RobertBaruch/OurGrammer/pin_driver/pin_driver_pots.jpg

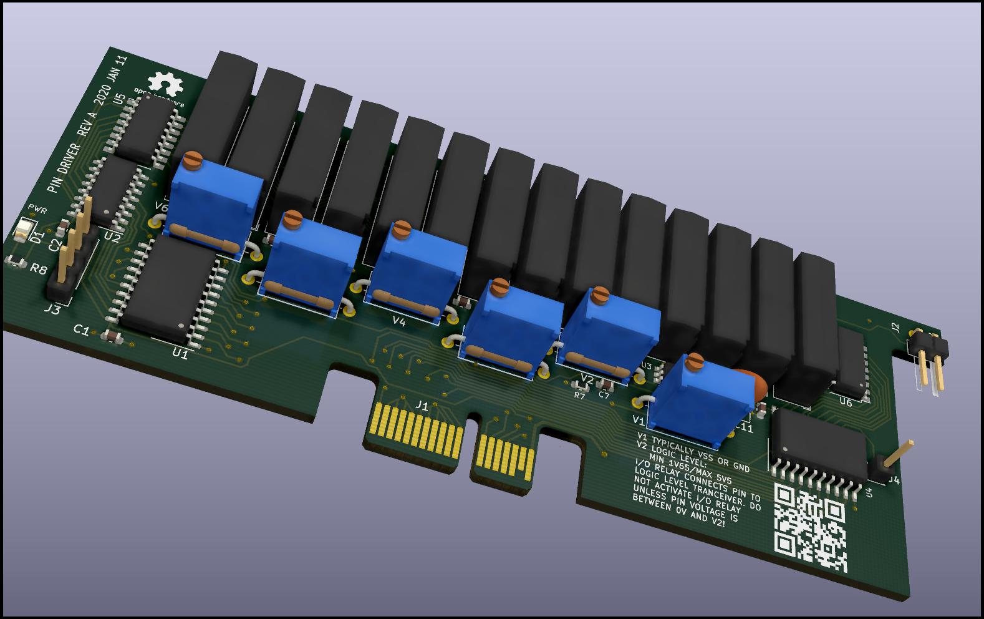
pin_driver/pin_driver_pots.jpg
