RobertBaruch/OurGrammer/pin_driver/pin_driver_qr.jpg

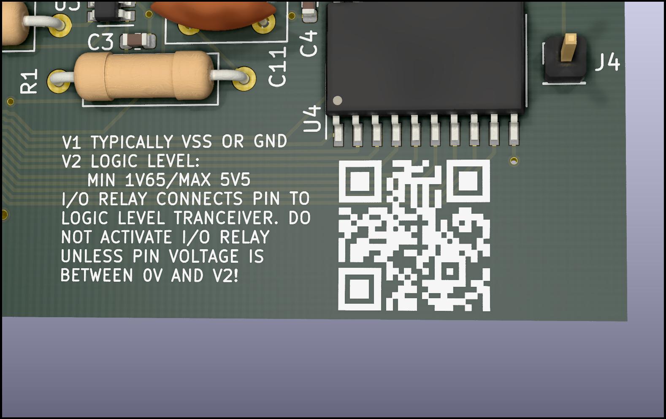
pin_driver/pin_driver_qr.jpg
