RobertBaruch/OurGrammer/pin_driver/pin_driver.jpg

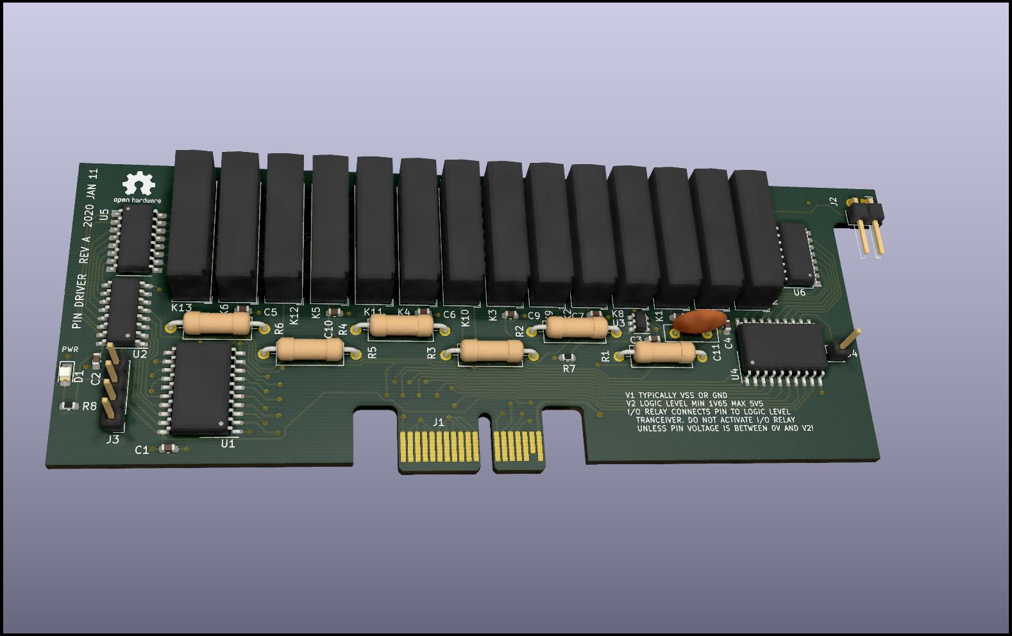
pin_driver/pin_driver.jpg
