RobertBaruch/OurGrammer/neg_voltages/voltages.kicad_pcb

## KiCad design neg_voltages/voltages.kicad_pcb (2020-05-23)

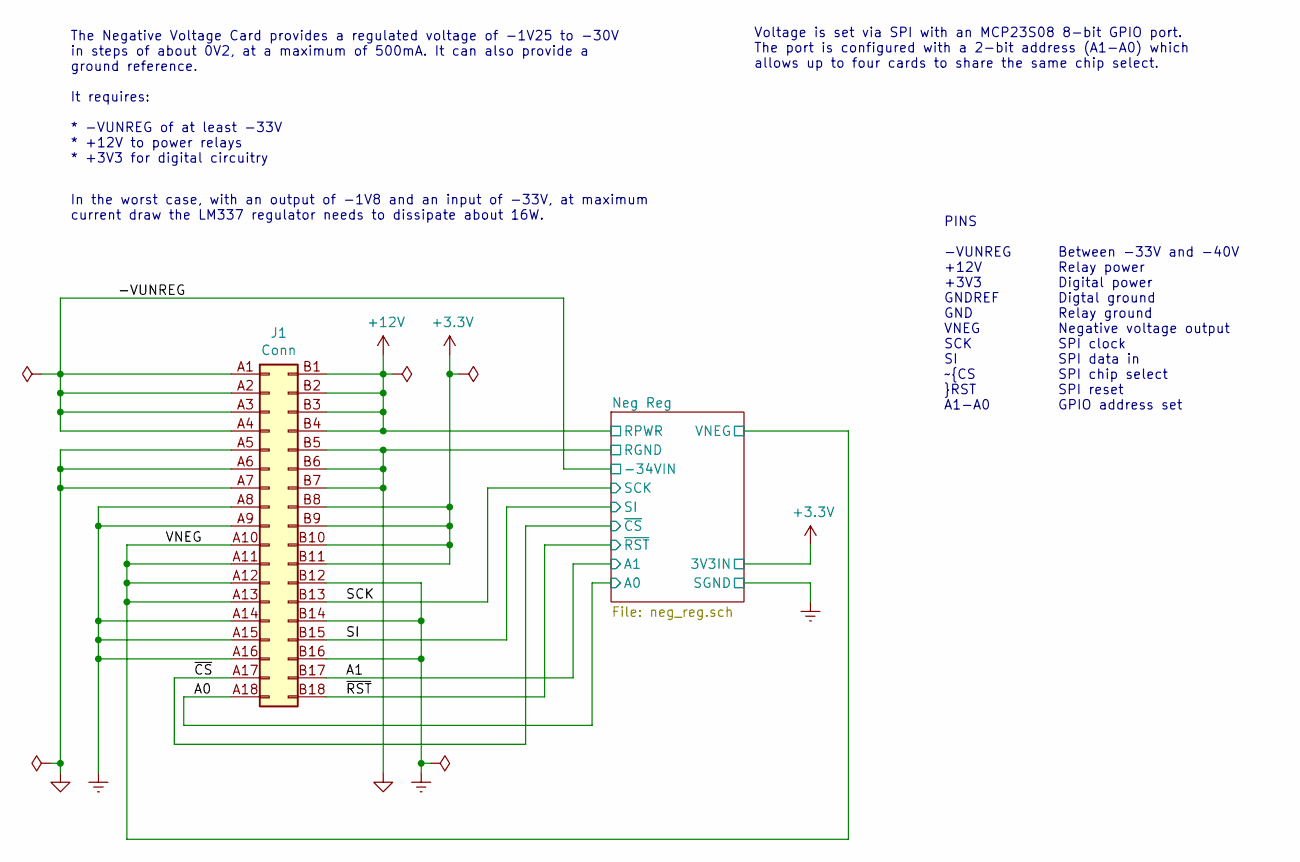
[picture p4: schematic voltages.sch]

Parts:
J1: Conn; BUS_PCIexpress_x1

Connections:
+3V3: J1.B8 (Pin_b8), J1.B9 (Pin_b9), J1.B10 (Pin_b10), J1.B11 (Pin_b11); also elsewhere on the board
+12V: J1.B1 (Pin_b1), J1.B2 (Pin_b2), J1.B3 (Pin_b3), J1.B4 (Pin_b4); also elsewhere on the board
/-VUNREG: J1.A1 (Pin_a1), J1.A2 (Pin_a2), J1.A3 (Pin_a3), J1.A4 (Pin_a4); also elsewhere on the board
/A0: J1.A18 (Pin_a18); also elsewhere on the board
/A1: J1.B17 (Pin_b17); also elsewhere on the board
/SCK: J1.B13 (Pin_b13); also elsewhere on the board
/SI: J1.B15 (Pin_b15); also elsewhere on the board
/VNEG: J1.A10 (Pin_a10), J1.A11 (Pin_a11), J1.A12 (Pin_a12), J1.A13 (Pin_a13); also elsewhere on the board
/~CS: J1.A17 (Pin_a17); also elsewhere on the board
/~RST: J1.B18 (Pin_b18); also elsewhere on the board
GND: J1.A5 (Pin_a5), J1.A6 (Pin_a6), J1.A7 (Pin_a7), J1.B5 (Pin_b5), J1.B6 (Pin_b6), J1.B7 (Pin_b7); also elsewhere on the board
GNDREF: J1.A8 (Pin_a8), J1.A9 (Pin_a9), J1.A14 (Pin_a14), J1.A15 (Pin_a15), J1.A16 (Pin_a16), J1.B12 (Pin_b12), J1.B14 (Pin_b14), J1.B16 (Pin_b16); also elsewhere on the board

Notes on the sheet:
The Negative Voltage Card provides a regulated voltage of -1V25 to -30V in steps of about 0V2, at a maximum of 500mA. It can also provide a ground reference. It requires: * -VUNREG of at least -33V * +12V to power relays * +3V3 for digital circuitry
In the worst case, with an output of -1V8 and an input of -33V, at maximum current draw the LM337 regulator needs to dissipate about 16W.
Voltage is set via SPI with an MCP23S08 8-bit GPIO port. The port is configured with a 2-bit address (A1-A0) which allows up to four cards to share the same chip select.
PINS -VUNREG +12V +3V3 GNDREF GND VNEG SCK SI ~CS ~RST A1-A0
Between -33V and -40V Relay power Digital power Digtal ground Relay ground Negative voltage output SPI clock SPI data in SPI chip select SPI reset GPIO address set

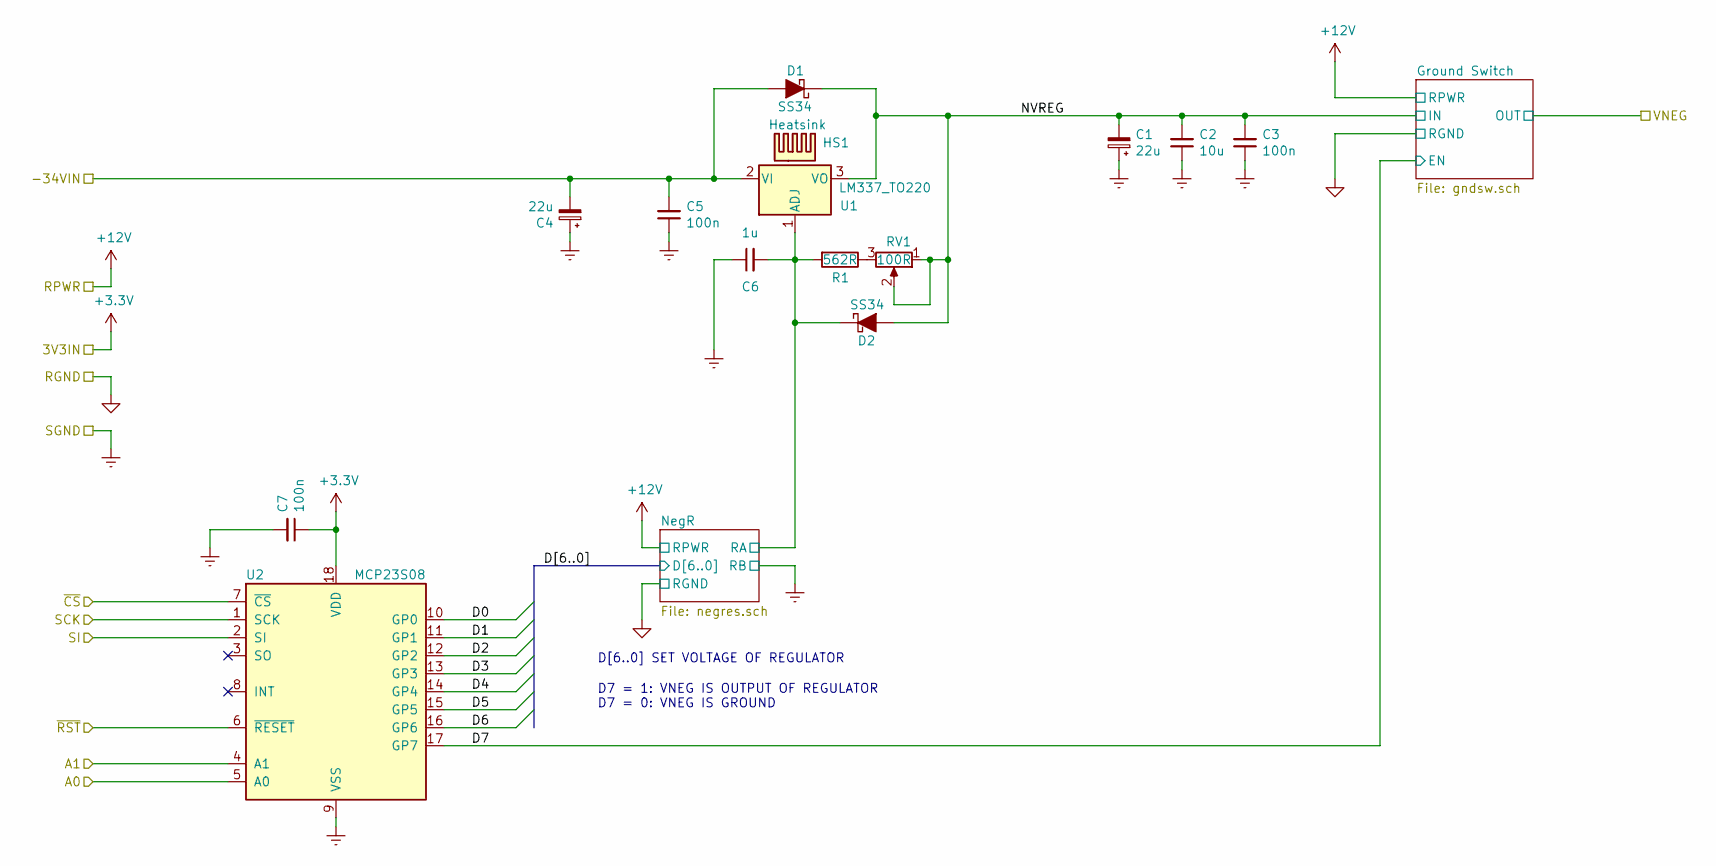
[picture p5: schematic neg_reg.sch]

Parts:
C1, C4: 22u; CP_Elec_6.3x7.7
C2: 10u; C_1206_3216Metric
C3, C5, C7: 100n; C_0805_2012Metric
C6: 1u; C_0805_2012Metric
D1, D2: SS34; D_SMA
HS1: Heatsink; Heatsink_22x10x25mm_1xFixation3mm
R1: 562R; R_0603_1608Metric
RV1: 100R; Potentiometer_Vishay_43_Horizontal
U1: LM337_TO220; TO-220-3_Horizontal_TabDown
U2: MCP23S08; SOIC-18W_7.5x11.6mm_P1.27mm

Connections:
+3V3: C7.1, U2.18 (VDD); also elsewhere on the board
/-VUNREG: C4.2, C5.2, D1.2 (A), U1.2 (VI); also elsewhere on the board
/A0: U2.5 (A0); also elsewhere on the board
/A1: U2.4 (A1); also elsewhere on the board
/Neg Reg/D0: U2.10 (GP0); also elsewhere on the board
/Neg Reg/D1: U2.11 (GP1); also elsewhere on the board
/Neg Reg/D2: U2.12 (GP2); also elsewhere on the board
/Neg Reg/D3: U2.13 (GP3); also elsewhere on the board
/Neg Reg/D4: U2.14 (GP4); also elsewhere on the board
/Neg Reg/D5: U2.15 (GP5); also elsewhere on the board
/Neg Reg/D6: U2.16 (GP6); also elsewhere on the board
/Neg Reg/D7: U2.17 (GP7); also elsewhere on the board
/Neg Reg/NVREG: C1.2, C2.2, C3.2, D1.1 (K), D2.2 (A), RV1.1, RV1.2, U1.3 (VO); also elsewhere on the board
/Neg Reg/NegR/RA: C6.2, D2.1 (K), R1.2, U1.1 (ADJ); also elsewhere on the board
/SCK: U2.1 (SCK); also elsewhere on the board
/SI: U2.2 (SI); also elsewhere on the board
/~CS: U2.7 (~CS); also elsewhere on the board
/~RST: U2.6 (~RESET); also elsewhere on the board
GNDREF: C1.1, C2.1, C3.1, C4.1, C5.1, C6.1, C7.2, U2.9 (VSS); also elsewhere on the board
unnamed: R1.1, RV1.3

Notes on the sheet:
D7 = 1: VNEG IS OUTPUT OF REGULATOR D7 = 0: VNEG IS GROUND
D[6..0] SET VOLTAGE OF REGULATOR

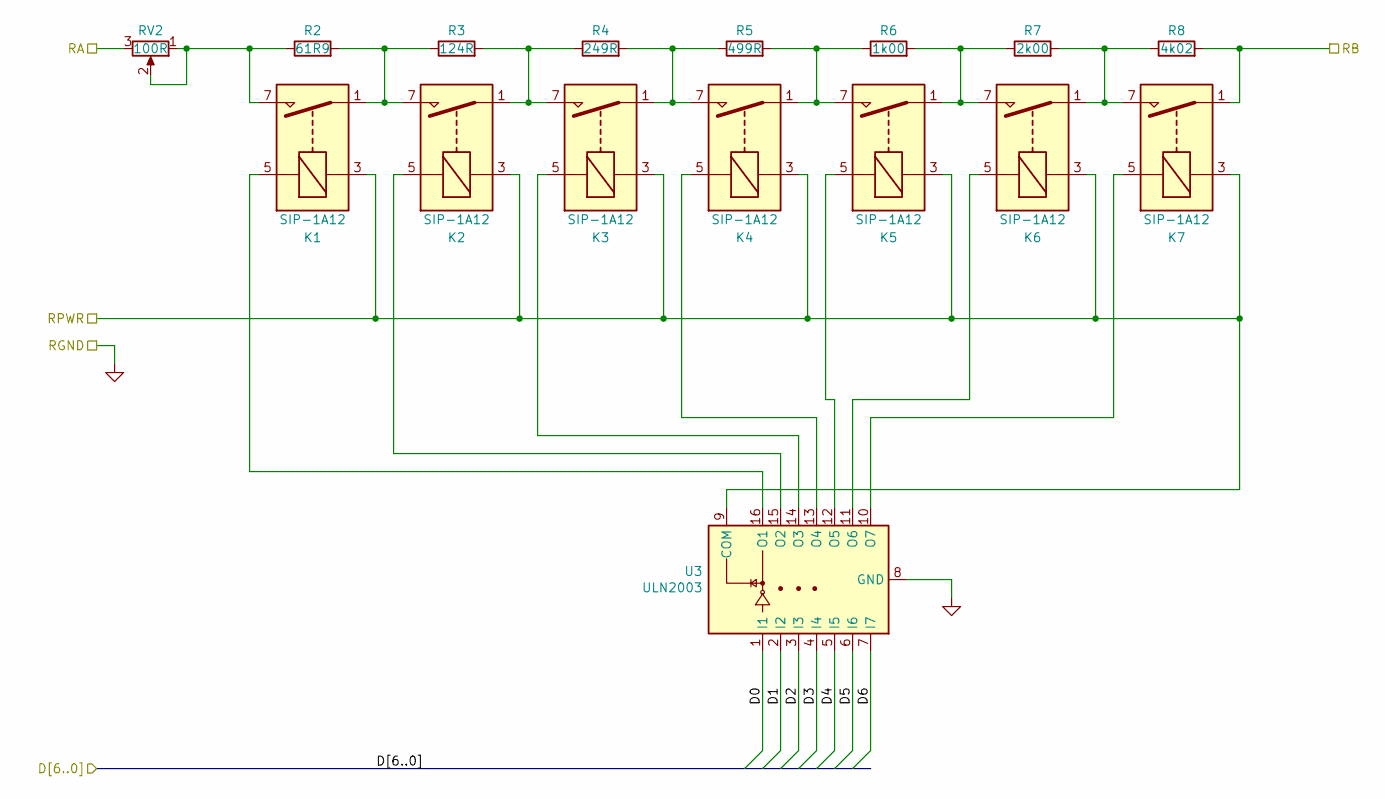
[picture p6: schematic negres.sch]

Parts:
K1, K2, K3, K4, K5, K6, K7: SIP-1A12; Relay_SPST_StandexMeder_SIL_Form1A
R2: 61R9; R_0603_1608Metric
R3: 124R; R_0603_1608Metric
R4: 249R; R_0603_1608Metric
R5: 499R; R_0603_1608Metric
R6: 1k00; R_0603_1608Metric
R7: 2k00; R_0603_1608Metric
R8: 4k02; R_0603_1608Metric
RV2: 100R; Potentiometer_Vishay_43_Horizontal
U3: ULN2003; SOP-16_4.4x10.4mm_P1.27mm

Connections:
+12V: K1.3, K2.3, K3.3, K4.3, K5.3, K6.3, K7.3, U3.9 (COM); also elsewhere on the board
/Neg Reg/D0: U3.1 (I1); also elsewhere on the board
/Neg Reg/D1: U3.2 (I2); also elsewhere on the board
/Neg Reg/D2: U3.3 (I3); also elsewhere on the board
/Neg Reg/D3: U3.4 (I4); also elsewhere on the board
/Neg Reg/D4: U3.5 (I5); also elsewhere on the board
/Neg Reg/D5: U3.6 (I6); also elsewhere on the board
/Neg Reg/D6: U3.7 (I7); also elsewhere on the board
/Neg Reg/NegR/RA: RV2.3; also elsewhere on the board
GND: U3.8 (GND); also elsewhere on the board
GNDREF: K7.1, R8.2; also elsewhere on the board
unnamed: K1.1, K2.7, R2.2, R3.1
unnamed: K1.5, U3.16 (O1)
unnamed: K1.7, R2.1, RV2.1, RV2.2
unnamed: K2.1, K3.7, R3.2, R4.1
unnamed: K2.5, U3.15 (O2)
unnamed: K3.1, K4.7, R4.2, R5.1
unnamed: K3.5, U3.14 (O3)
unnamed: K4.1, K5.7, R5.2, R6.1
unnamed: K4.5, U3.13 (O4)
unnamed: K5.1, K6.7, R6.2, R7.1
unnamed: K5.5, U3.12 (O5)
unnamed: K6.1, K7.7, R7.2, R8.1
unnamed: K6.5, U3.11 (O6)
unnamed: K7.5, U3.10 (O7)

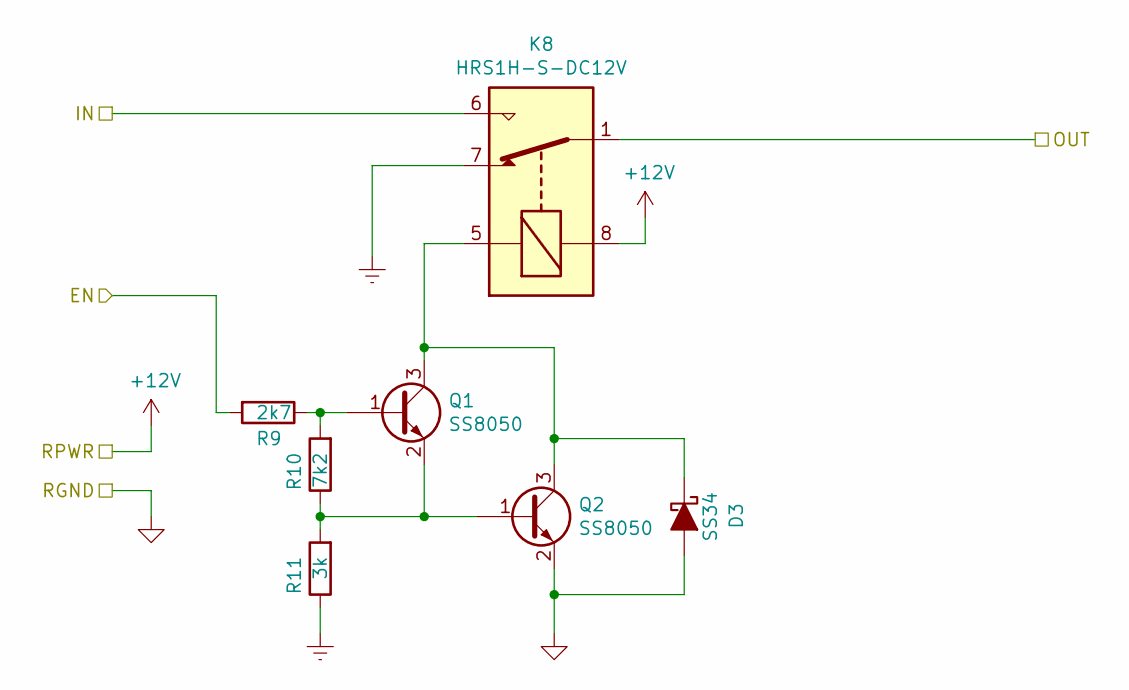
[picture p7: schematic gndsw.sch]

Parts:
D3: SS34; D_SMA
K8: HRS1H-S-DC12V; Relay_SPDT_HJR-4102
Q1, Q2: SS8050; SOT-23
R9: 2k7; R_0603_1608Metric
R10: 7k2; R_0603_1608Metric
R11: 3k; R_0603_1608Metric

Connections:
+12V: K8.8 (C2); also elsewhere on the board
/Neg Reg/D7: R9.2; also elsewhere on the board
/Neg Reg/NVREG: K8.6 (NO); also elsewhere on the board
/VNEG: K8.1 (COM), K8.12; also elsewhere on the board
GND: D3.2 (A), Q2.2 (E); also elsewhere on the board
GNDREF: K8.7 (NC), R11.1; also elsewhere on the board
unnamed: D3.1 (K), K8.5 (C1), Q1.3 (C), Q2.3 (C)
unnamed: Q1.1 (B), R9.1, R10.2
unnamed: Q1.2 (E), Q2.1 (B), R10.1, R11.2

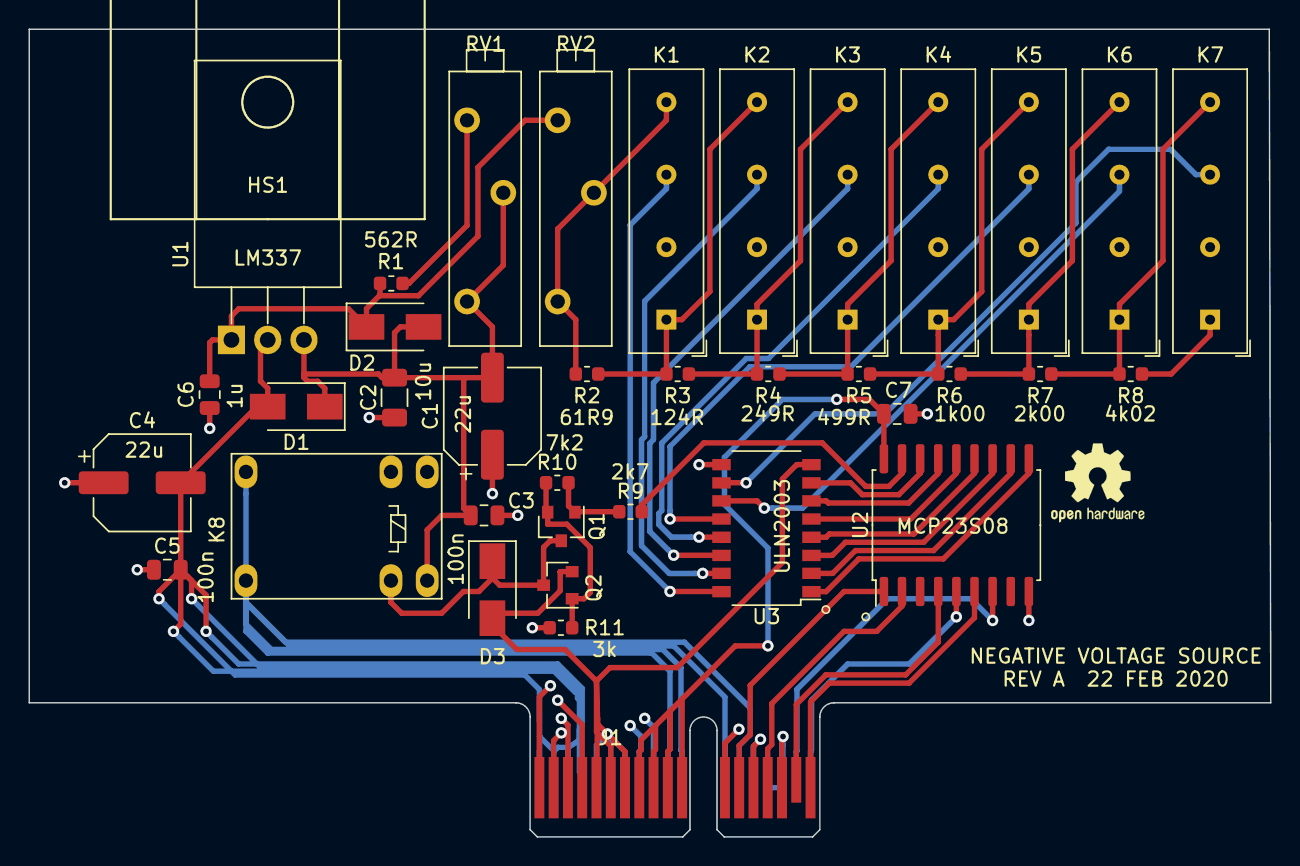
[picture p8: board voltages.kicad_pcb from above]

Board: 4 copper layers, 87.0 x 56.6 mm, 38 parts (0 on the bottom side), 40 nets.
