RobertBaruch/OurGrammer/pin_driver/pin_driver.kicad_pcb

## KiCad design pin_driver/pin_driver.kicad_pcb (2020-05-23)

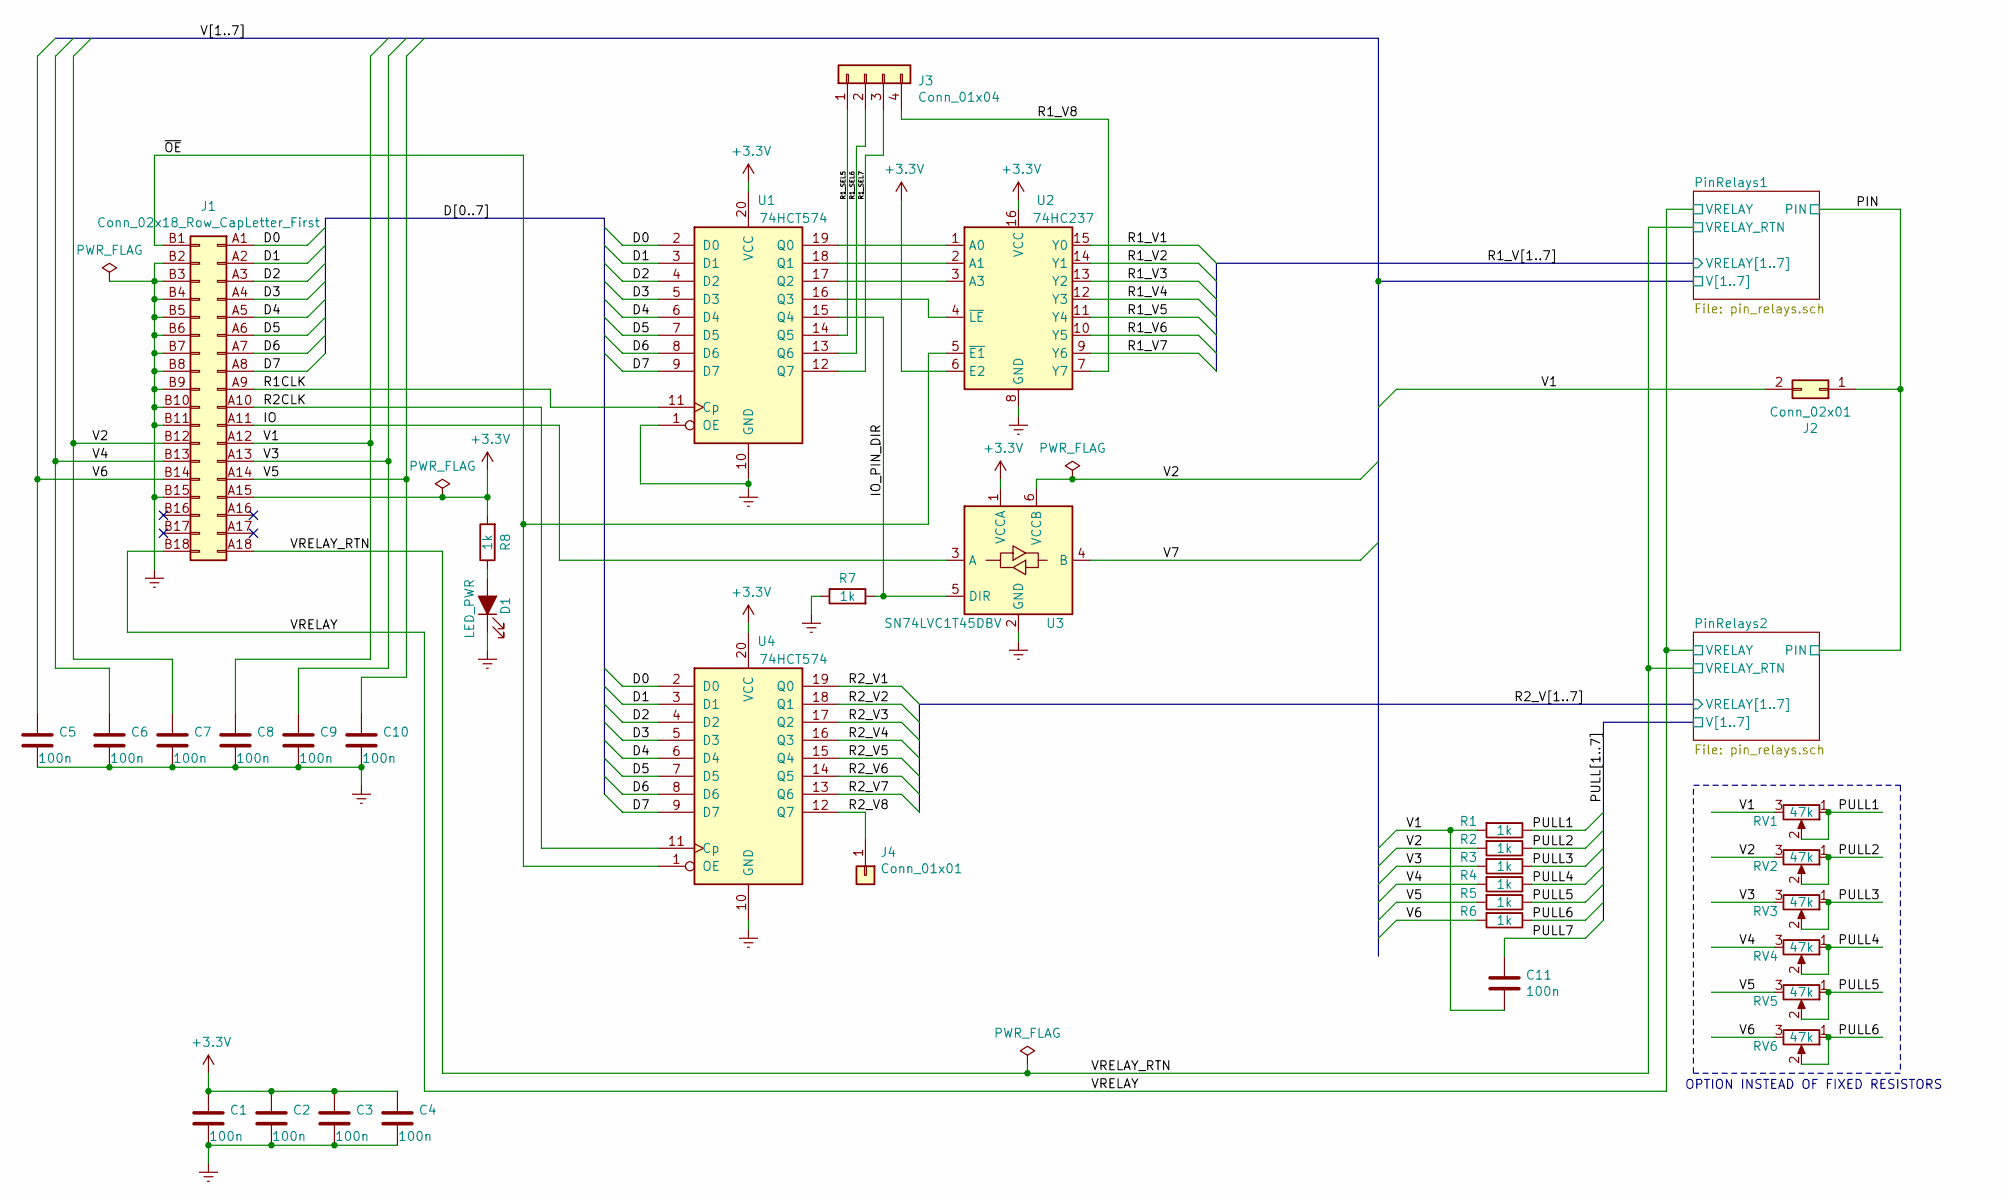
[picture p9: schematic pin_driver.sch]

Parts:
C1, C2, C3, C4, C5, C6, C7, C8, C9, C10: 100n; C_0603_1608Metric
C11: 100n; C_Disc_D8.0mm_W2.5mm_P5.00mm
D1: LED_PWR; LED_0805_2012Metric_Castellated
J1: Conn_02x18_Row_CapLetter_First; BUS_PCIexpress_x1
J2: Conn_02x01; PinHeader_1x02_P2.54mm_Horizontal
J3: Conn_01x04; PinHeader_1x04_P2.54mm_Vertical
J4: Conn_01x01; PinHeader_1x01_P2.54mm_Vertical
R1, R2, R3, R4, R5, R6: 1k; R_Axial_DIN0309_L9.0mm_D3.2mm_P12.70mm_Horizontal
R7, R8: 1k; R_0603_1608Metric
RV1, RV2, RV3, RV4, RV5, RV6: 47k; Potentiometer_Bourns_3296W_Vertical
U1, U4: 74HCT574; SO-20_12.8x7.5mm_P1.27mm
U2: 74HC237; SOIC-16_3.9x9.9mm_P1.27mm
U3: SN74LVC1T45DBV; SOT-23-6

Connections:
+3V3: C1.1, C2.1, C3.1, C4.1, J1.A15 (Pin_a15), R8.2, U1.20 (VCC), U2.6 (E2), U2.16 (VCC), U3.1 (VCCA), U4.20 (VCC)
/D0: J1.A1 (Pin_a1), U1.2 (D0), U4.2 (D0)
/D1: J1.A2 (Pin_a2), U1.3 (D1), U4.3 (D1)
/D2: J1.A3 (Pin_a3), U1.4 (D2), U4.4 (D2)
/D3: J1.A4 (Pin_a4), U1.5 (D3), U4.5 (D3)
/D4: J1.A5 (Pin_a5), U1.6 (D4), U4.6 (D4)
/D5: J1.A6 (Pin_a6), U1.7 (D5), U4.7 (D5)
/D6: J1.A7 (Pin_a7), U1.8 (D6), U4.8 (D6)
/D7: J1.A8 (Pin_a8), U1.9 (D7), U4.9 (D7)
/IO: J1.A11 (Pin_a11), U3.3 (A)
/IO_PIN_DIR: R7.2, U1.15 (Q4), U3.5 (DIR)
/PIN: J2.1; also elsewhere on the board
/PULL1: R1.1, RV1.1, RV1.2; also elsewhere on the board
/PULL2: R2.1, RV2.1, RV2.2; also elsewhere on the board
/PULL3: R3.1, RV3.1, RV3.2; also elsewhere on the board
/PULL4: R4.1, RV4.1, RV4.2; also elsewhere on the board
/PULL5: R5.1, RV5.1, RV5.2; also elsewhere on the board
/PULL6: R6.1, RV6.1, RV6.2; also elsewhere on the board
/PULL7: C11.1; also elsewhere on the board
/R1CLK: J1.A9 (Pin_a9), U1.11 (Cp)
/R1_SEL5: J3.1, U1.14 (Q5)
/R1_SEL6: J3.2, U1.13 (Q6)
/R1_SEL7: J3.3, U1.12 (Q7)
/R1_V1: U2.15 (Y0); also elsewhere on the board
/R1_V2: U2.14 (Y1); also elsewhere on the board
/R1_V3: U2.13 (Y2); also elsewhere on the board
/R1_V4: U2.12 (Y3); also elsewhere on the board
/R1_V5: U2.11 (Y4); also elsewhere on the board
/R1_V6: U2.10 (Y5); also elsewhere on the board
/R1_V7: U2.9 (Y6); also elsewhere on the board
/R1_V8: J3.4, U2.7 (Y7)
/R2CLK: J1.A10 (Pin_a10), U4.11 (Cp)
/R2_V1: U4.19 (Q0); also elsewhere on the board
/R2_V2: U4.18 (Q1); also elsewhere on the board
/R2_V3: U4.17 (Q2); also elsewhere on the board
/R2_V4: U4.16 (Q3); also elsewhere on the board
/R2_V5: U4.15 (Q4); also elsewhere on the board
/R2_V6: U4.14 (Q5); also elsewhere on the board
/R2_V7: U4.13 (Q6); also elsewhere on the board
/R2_V8: J4.1, U4.12 (Q7)
/V1: C8.1, C11.2, J1.A12 (Pin_a12), J2.2, R1.2, RV1.3; also elsewhere on the board
/V2: C7.1, J1.B12 (Pin_b12), R2.2, RV2.3, U3.6 (VCCB); also elsewhere on the board
/V3: C9.1, J1.A13 (Pin_a13), R3.2, RV3.3; also elsewhere on the board
/V4: C6.1, J1.B13 (Pin_b13), R4.2, RV4.3; also elsewhere on the board
/V5: C10.1, J1.A14 (Pin_a14), R5.2, RV5.3; also elsewhere on the board
/V6: C5.1, J1.B14 (Pin_b14), R6.2, RV6.3; also elsewhere on the board
/V7: U3.4 (B); also elsewhere on the board
/VRELAY: J1.B18 (Pin_b18); also elsewhere on the board
/VRELAY_RTN: J1.A18 (Pin_a18); also elsewhere on the board
/~OE: J1.B1 (Pin_b1), U2.5 (~E1), U4.1 (OE)
GNDREF: C1.2, C2.2, C3.2, C4.2, C5.2, C6.2, C7.2, C8.2, C9.2, C10.2, D1.1 (K), J1.B2 (Pin_b2), J1.B3 (Pin_b3), J1.B4 (Pin_b4), J1.B5 (Pin_b5), J1.B6 (Pin_b6), J1.B7 (Pin_b7), J1.B8 (Pin_b8), J1.B9 (Pin_b9), J1.B10 (Pin_b10), J1.B11 (Pin_b11), J1.B15 (Pin_b15), R7.1, U1.1 (OE), U1.10 (GND), U2.8 (GND), U3.2 (GND), U4.10 (GND)
unnamed: D1.2 (A), R8.1
unnamed: U1.16 (Q3), U2.4 (~LE)
unnamed: U1.17 (Q2), U2.3 (A3)
unnamed: U1.18 (Q1), U2.2 (A1)
unnamed: U1.19 (Q0), U2.1 (A0)

Notes on the sheet:
OPTION INSTEAD OF FIXED RESISTORS

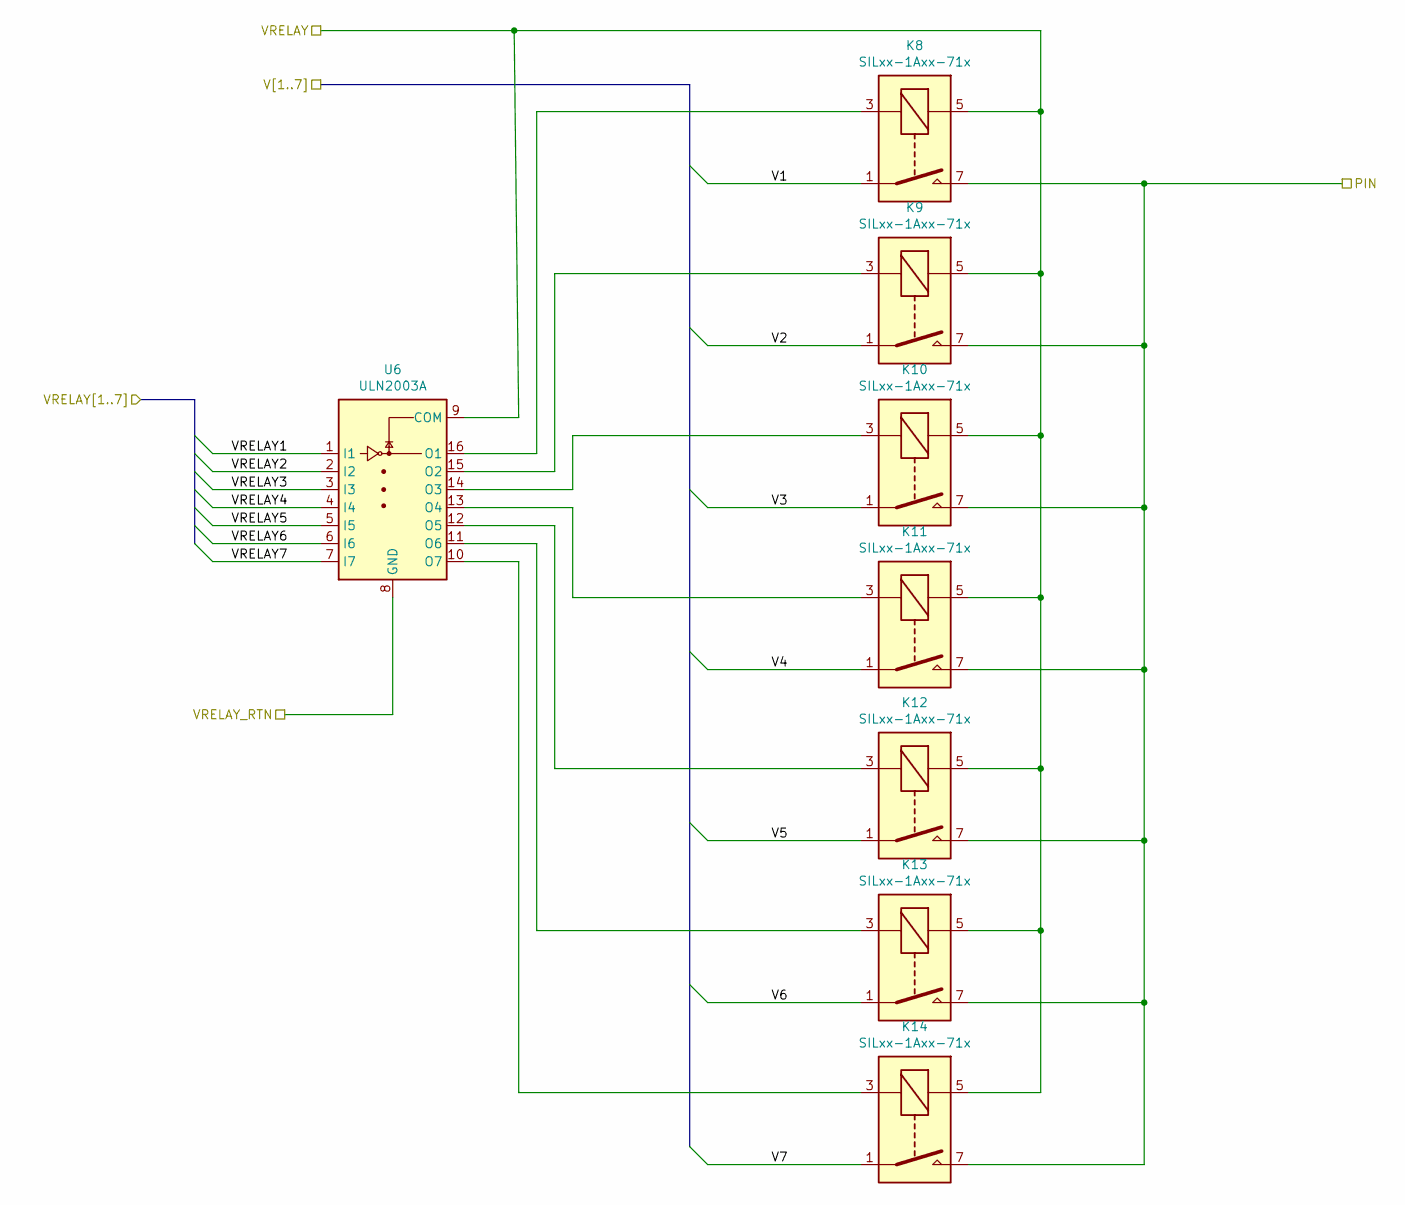
[picture p10: schematic pin_relays.sch]

Parts:
K1, K2, K3, K4, K5, K6, K7: SILxx-1Axx-71x; Relay_SPST_StandexMeder_SIL_Form1A
U5: ULN2003A; SOP-16_4.4x10.4mm_P1.27mm

Connections:
/PIN: K1.7, K2.7, K3.7, K4.7, K5.7, K6.7, K7.7; also elsewhere on the board
/R1_V1: U5.1 (I1); also elsewhere on the board
/R1_V2: U5.2 (I2); also elsewhere on the board
/R1_V3: U5.3 (I3); also elsewhere on the board
/R1_V4: U5.4 (I4); also elsewhere on the board
/R1_V5: U5.5 (I5); also elsewhere on the board
/R1_V6: U5.6 (I6); also elsewhere on the board
/R1_V7: U5.7 (I7); also elsewhere on the board
/V1: K1.1; also elsewhere on the board
/V2: K2.1; also elsewhere on the board
/V3: K3.1; also elsewhere on the board
/V4: K4.1; also elsewhere on the board
/V5: K5.1; also elsewhere on the board
/V6: K6.1; also elsewhere on the board
/V7: K7.1; also elsewhere on the board
/VRELAY: K1.5, K2.5, K3.5, K4.5, K5.5, K6.5, K7.5, U5.9 (COM); also elsewhere on the board
/VRELAY_RTN: U5.8 (GND); also elsewhere on the board
unnamed: K1.3, U5.16 (O1)
unnamed: K2.3, U5.15 (O2)
unnamed: K3.3, U5.14 (O3)
unnamed: K4.3, U5.13 (O4)
unnamed: K5.3, U5.12 (O5)
unnamed: K6.3, U5.11 (O6)
unnamed: K7.3, U5.10 (O7)

Parts of its further copies:
K8, K9, K10, K11, K12, K13, K14: SILxx-1Axx-71x; Relay_SPST_StandexMeder_SIL_Form1A
U6: ULN2003A; SOP-16_4.4x10.4mm_P1.27mm

Connections of its further copies:
/PIN: K8.7, K9.7, K10.7, K11.7, K12.7, K13.7, K14.7; also elsewhere on the board
/PULL1: K8.1; also elsewhere on the board
/PULL2: K9.1; also elsewhere on the board
/PULL3: K10.1; also elsewhere on the board
/PULL4: K11.1; also elsewhere on the board
/PULL5: K12.1; also elsewhere on the board
/PULL6: K13.1; also elsewhere on the board
/PULL7: K14.1; also elsewhere on the board
/R2_V1: U6.1 (I1); also elsewhere on the board
/R2_V2: U6.2 (I2); also elsewhere on the board
/R2_V3: U6.3 (I3); also elsewhere on the board
/R2_V4: U6.4 (I4); also elsewhere on the board
/R2_V5: U6.5 (I5); also elsewhere on the board
/R2_V6: U6.6 (I6); also elsewhere on the board
/R2_V7: U6.7 (I7); also elsewhere on the board
/VRELAY: K8.5, K9.5, K10.5, K11.5, K12.5, K13.5, K14.5, U6.9 (COM); also elsewhere on the board
/VRELAY_RTN: U6.8 (GND); also elsewhere on the board
unnamed: K8.3, U6.16 (O1)
unnamed: K9.3, U6.15 (O2)
unnamed: K10.3, U6.14 (O3)
unnamed: K11.3, U6.13 (O4)
unnamed: K12.3, U6.12 (O5)
unnamed: K13.3, U6.11 (O6)
unnamed: K14.3, U6.10 (O7)

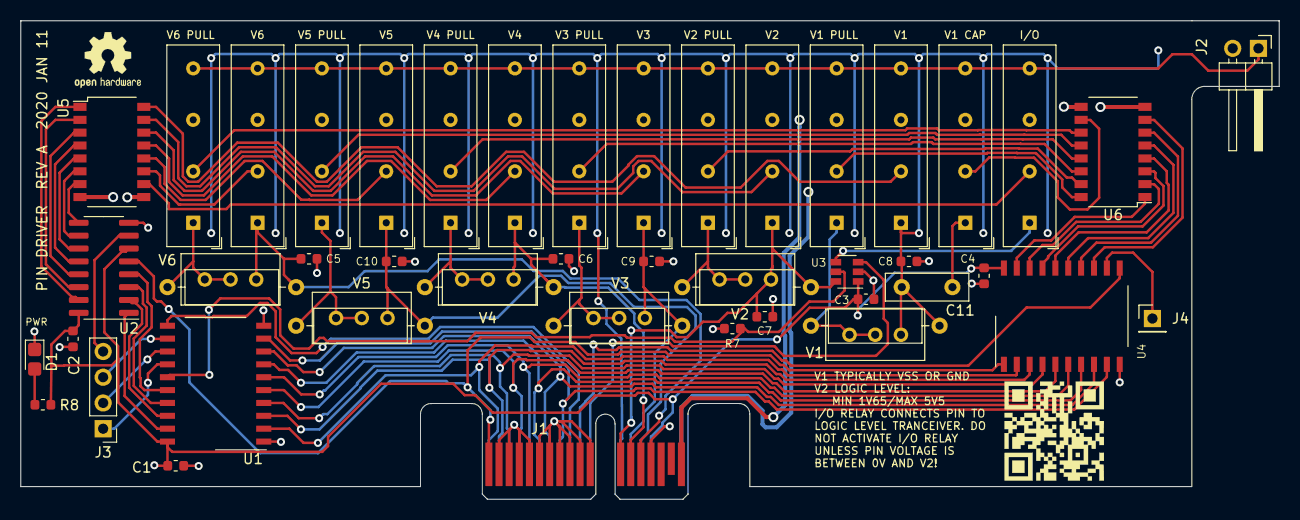
[picture p11: board pin_driver/pin_driver.kicad_pcb from above]

Board: 4 copper layers, 124.2 x 47.2 mm, 51 parts (0 on the bottom side), 70 nets.

Other parts of the board:
Ref**: Val**; rickroll_qr
