RobertBaruch/OurGrammer/pin_driver4/pin_driver.kicad_pcb

## KiCad design pin_driver4/pin_driver.kicad_pcb (2020-05-23)

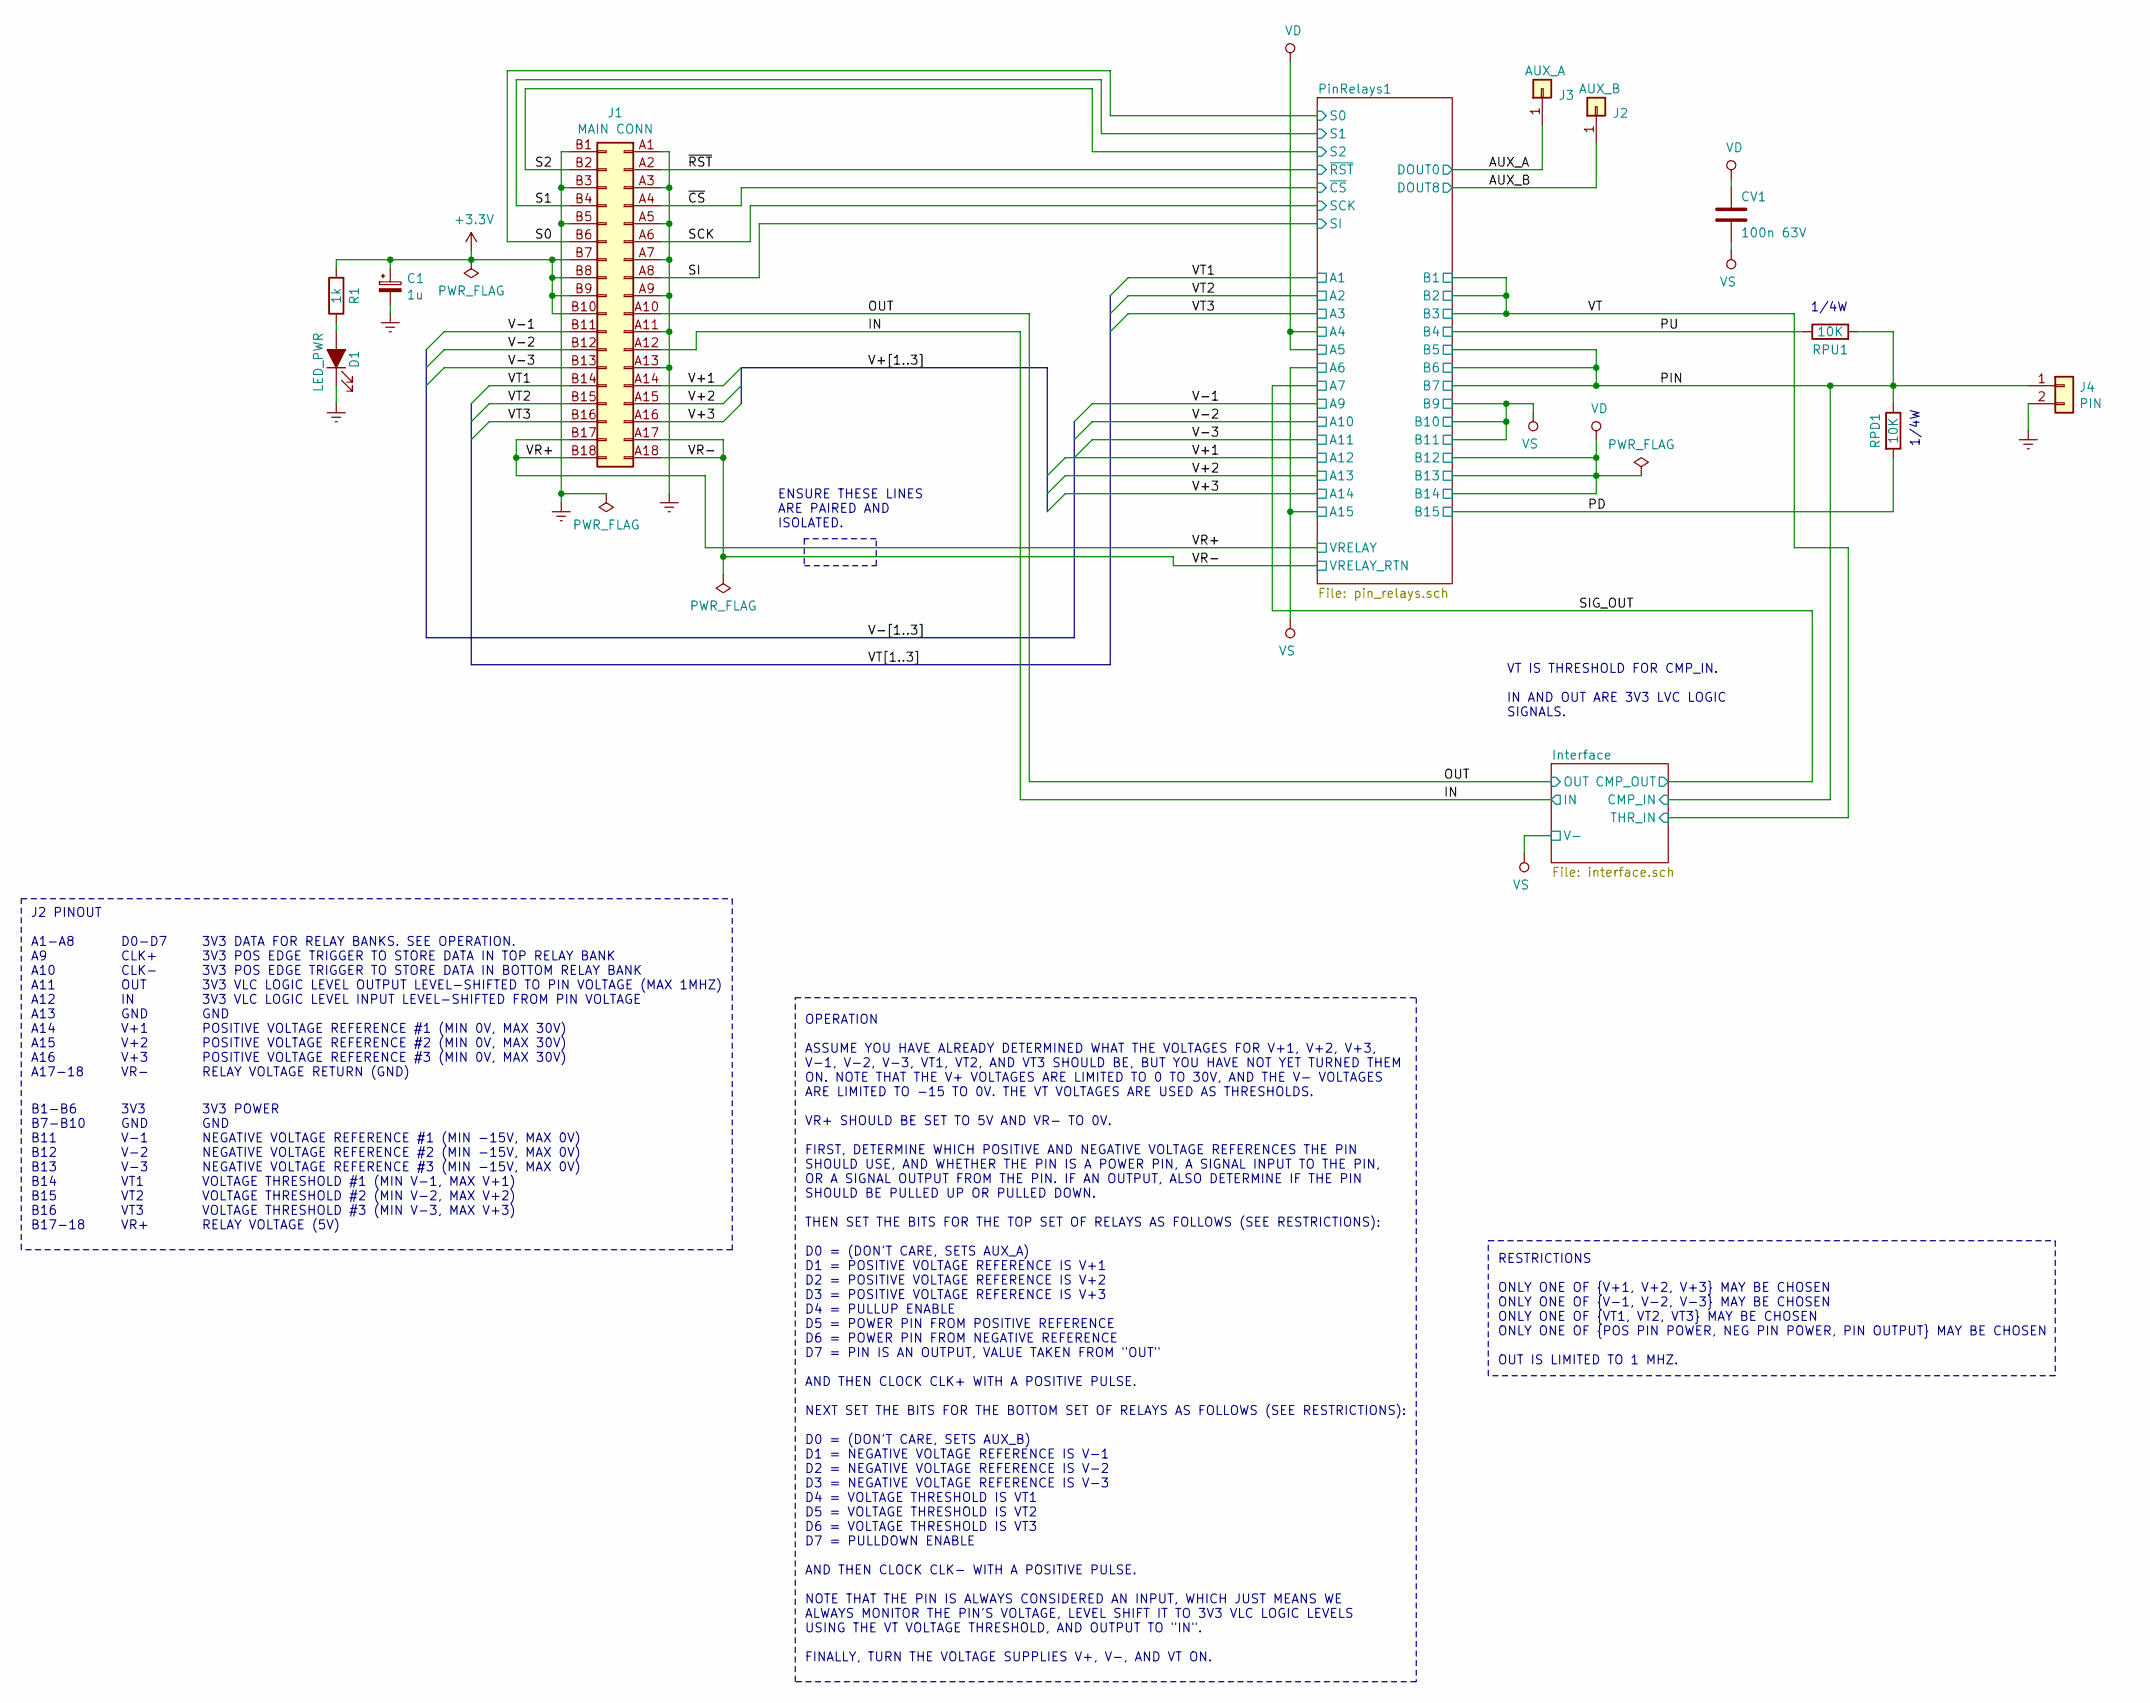
[picture p12: schematic pin_driver.sch, PIN DRIVER]

Parts:
C1: 1u; CP_Elec_4x5.4
CV1: 100n 63V; C_0805_2012Metric
D1: LED_PWR; LED_0805_2012Metric_Castellated
J1: MAIN CONN; BUS_PCIexpress_x1
J2: AUX_B; PinHeader_1x01_P2.54mm_Vertical
J3: AUX_A; PinHeader_1x01_P2.54mm_Vertical
J4: PIN; PinHeader_1x02_P2.54mm_Horizontal
R1: 1k; R_0603_1608Metric
RPD1: 10K; R_1206_3216Metric
RPU1: 10K; R_1206_3216Metric

Connections:
+3V3: C1.1, J1.B7 (Pin_b7), J1.B8 (Pin_b8), J1.B9 (Pin_b9), J1.B10 (Pin_b10), R1.2; also elsewhere on the board
/AUX_A: J3.1; also elsewhere on the board
/AUX_B: J2.1; also elsewhere on the board
/IN: J1.A12 (Pin_a12); also elsewhere on the board
/OUT: J1.A10 (Pin_a10); also elsewhere on the board
/PD: RPD1.2; also elsewhere on the board
/PIN: J4.1, RPD1.1, RPU1.2; also elsewhere on the board
/PU: RPU1.1; also elsewhere on the board
/S0: J1.B6 (Pin_b6); also elsewhere on the board
/S1: J1.B4 (Pin_b4); also elsewhere on the board
/S2: J1.B2 (Pin_b2); also elsewhere on the board
/SCK: J1.A6 (Pin_a6); also elsewhere on the board
/SI: J1.A8 (Pin_a8); also elsewhere on the board
/V+1: J1.A14 (Pin_a14); also elsewhere on the board
/V+2: J1.A15 (Pin_a15); also elsewhere on the board
/V+3: J1.A16 (Pin_a16); also elsewhere on the board
/V-1: J1.B11 (Pin_b11); also elsewhere on the board
/V-2: J1.B12 (Pin_b12); also elsewhere on the board
/V-3: J1.B13 (Pin_b13); also elsewhere on the board
/VR+: J1.B17 (Pin_b17), J1.B18 (Pin_b18); also elsewhere on the board
/VR-: J1.A17 (Pin_a17), J1.A18 (Pin_a18); also elsewhere on the board
/VT1: J1.B14 (Pin_b14); also elsewhere on the board
/VT2: J1.B15 (Pin_b15); also elsewhere on the board
/VT3: J1.B16 (Pin_b16); also elsewhere on the board
/~CS: J1.A4 (Pin_a4); also elsewhere on the board
/~RST: J1.A2 (Pin_a2); also elsewhere on the board
GNDREF: C1.2, D1.1 (K), J1.A1 (Pin_a1), J1.A3 (Pin_a3), J1.A5 (Pin_a5), J1.A7 (Pin_a7), J1.A9 (Pin_a9), J1.A11 (Pin_a11), J1.A13 (Pin_a13), J1.B1 (Pin_b1), J1.B3 (Pin_b3), J1.B5 (Pin_b5), J4.2; also elsewhere on the board
unnamed: D1.2 (A), R1.1
VD: CV1.1; also elsewhere on the board
VS: CV1.2; also elsewhere on the board

Notes on the sheet:
1/4W
ENSURE THESE LINES ARE PAIRED AND ISOLATED.
VT IS THRESHOLD FOR CMP_IN. IN AND OUT ARE 3V3 LVC LOGIC SIGNALS.
RESTRICTIONS ONLY ONE OF {V+1, V+2, V+3} MAY BE CHOSEN ONLY ONE OF {V-1, V-2, V-3} MAY BE CHOSEN ONLY ONE OF {VT1, VT2, VT3} MAY BE CHOSEN ONLY ONE OF {POS PIN POWER, NEG PIN POWER, PIN OUTPUT} MAY BE CHOSEN OUT IS LIMITED TO 1 MHZ.
OPERATION ASSUME YOU HAVE ALREADY DETERMINED WHAT THE VOLTAGES FOR V+1, V+2, V+3, V-1, V-2, V-3, VT1, VT2, AND VT3 SHOULD BE, BUT YOU HAVE NOT YET TURNED THEM ON. NOTE THAT THE V+ VOLTAGES ARE LIMITED TO 0 TO 30V, AND THE V- VOLTAGES ARE LIMITED TO -15 TO 0V. THE VT VOLTAGES ARE USED AS THRESHOLDS.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
J2 PINOUT A1-A8 A9 A10 A11 A12 A13 A14 A15 A16 A17-18
D0-D7 CLK+ CLK- OUT IN GND V+1 V+2 V+3 VR-
3V3 DATA FOR RELAY BANKS. SEE OPERATION. 3V3 POS EDGE TRIGGER TO STORE DATA IN TOP RELAY BANK 3V3 POS EDGE TRIGGER TO STORE DATA IN BOTTOM RELAY BANK 3V3 VLC LOGIC LEVEL OUTPUT LEVEL-SHIFTED TO PIN VOLTAGE (MAX 1MHZ) 3V3 VLC LOGIC LEVEL INPUT LEVEL-SHIFTED FROM PIN VOLTAGE GND POSITIVE VOLTAGE REFE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
B1-B6 B7-B10 B11 B12 B13 B14 B15 B16 B17-18
3V3 GND V-1 V-2 V-3 VT1 VT2 VT3 VR+
3V3 POWER GND NEGATIVE VOLTAGE REFERENCE #1 (MIN -15V, MAX 0V) NEGATIVE VOLTAGE REFERENCE #2 (MIN -15V, MAX 0V) NEGATIVE VOLTAGE REFERENCE #3 (MIN -15V, MAX 0V) VOLTAGE THRESHOLD #1 (MIN V-1, MAX V+1) VOLTAGE THRESHOLD #2 (MIN V-2, MAX V+2) VOLTAGE THRESHOLD #3 (MIN V-3, MAX V+3) RELAY VOLTAGE (5V)
