RobertBaruch/OurGrammer/pin_driver4/pin_driver.kicad_pcb

## KiCad design pin_driver4/pin_driver.kicad_pcb (continued)

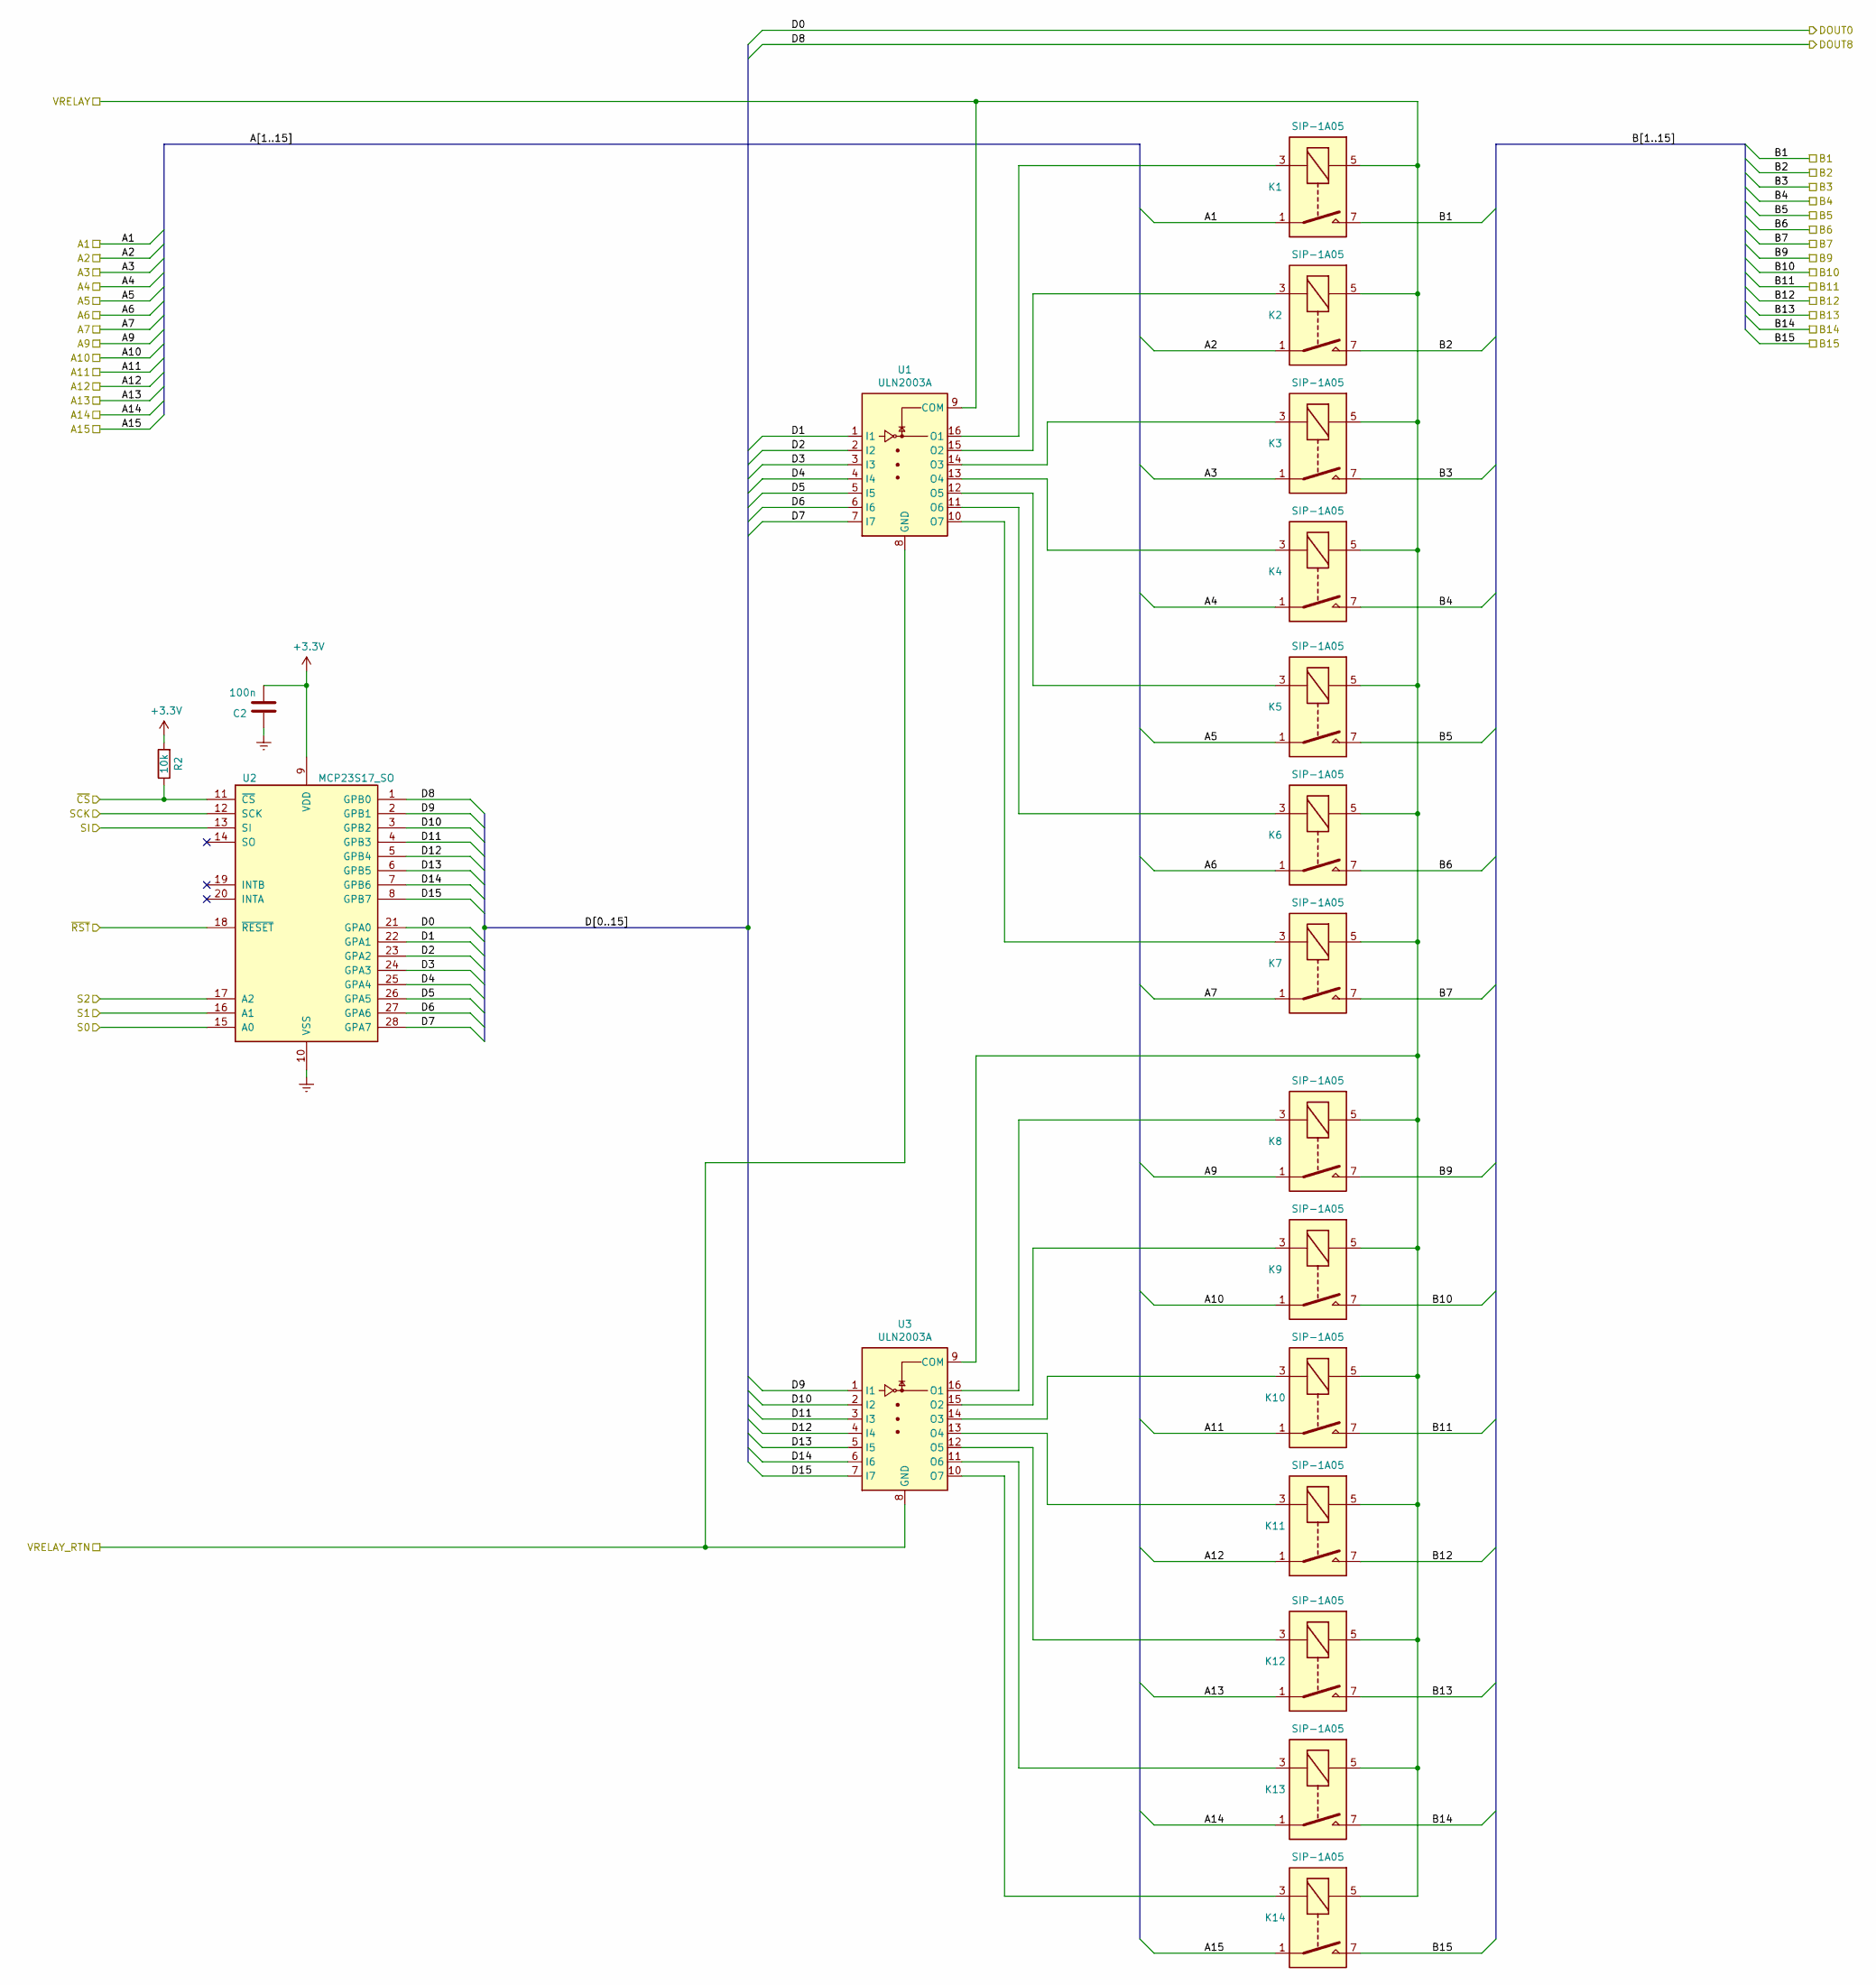
[picture p13: schematic pin_relays.sch, REGISTERED RELAYS]

Parts:
C2: 100n; C_0603_1608Metric
K1, K2, K3, K4, K5, K6, K7, K8, K9, K10, K11, K12, K13, K14: SIP-1A05; Relay_SPST_StandexMeder_SIL_Form1A
R2: 10k; R_0603_1608Metric
U1, U3: ULN2003A; SOP-16_4.4x10.4mm_P1.27mm
U2: MCP23S17_SO; SOIC-28W_7.5x17.9mm_P1.27mm

Connections:
+3V3: C2.2, R2.2, U2.9 (VDD); also elsewhere on the board
/AUX_A: U2.21 (GPA0); also elsewhere on the board
/AUX_B: U2.1 (GPB0); also elsewhere on the board
/PD: K14.7; also elsewhere on the board
/PIN: K5.7, K6.7, K7.7; also elsewhere on the board
/PU: K4.7; also elsewhere on the board
/PinRelays1/D1: U1.1 (I1), U2.22 (GPA1)
/PinRelays1/D2: U1.2 (I2), U2.23 (GPA2)
/PinRelays1/D3: U1.3 (I3), U2.24 (GPA3)
/PinRelays1/D4: U1.4 (I4), U2.25 (GPA4)
/PinRelays1/D5: U1.5 (I5), U2.26 (GPA5)
/PinRelays1/D6: U1.6 (I6), U2.27 (GPA6)
/PinRelays1/D7: U1.7 (I7), U2.28 (GPA7)
/PinRelays1/D9: U2.2 (GPB1), U3.1 (I1)
/PinRelays1/D10: U2.3 (GPB2), U3.2 (I2)
/PinRelays1/D11: U2.4 (GPB3), U3.3 (I3)
/PinRelays1/D12: U2.5 (GPB4), U3.4 (I4)
/PinRelays1/D13: U2.6 (GPB5), U3.5 (I5)
/PinRelays1/D14: U2.7 (GPB6), U3.6 (I6)
/PinRelays1/D15: U2.8 (GPB7), U3.7 (I7)
/S0: U2.15 (A0); also elsewhere on the board
/S1: U2.16 (A1); also elsewhere on the board
/S2: U2.17 (A2); also elsewhere on the board
/SCK: U2.12 (SCK); also elsewhere on the board
/SI: U2.13 (SI); also elsewhere on the board
/SIG_OUT: K7.1; also elsewhere on the board
/V+1: K11.1; also elsewhere on the board
/V+2: K12.1; also elsewhere on the board
/V+3: K13.1; also elsewhere on the board
/V-1: K8.1; also elsewhere on the board
/V-2: K9.1; also elsewhere on the board
/V-3: K10.1; also elsewhere on the board
/VR+: K1.5, K2.5, K3.5, K4.5, K5.5, K6.5, K7.5, K8.5, K9.5, K10.5, K11.5, K12.5, K13.5, K14.5, U1.9 (COM), U3.9 (COM); also elsewhere on the board
/VR-: U1.8 (GND), U3.8 (GND); also elsewhere on the board
/VT: K1.7, K2.7, K3.7; also elsewhere on the board
/VT1: K1.1; also elsewhere on the board
/VT2: K2.1; also elsewhere on the board
/VT3: K3.1; also elsewhere on the board
/~CS: R2.1, U2.11 (~CS~); also elsewhere on the board
/~RST: U2.18 (~RESET~); also elsewhere on the board
GNDREF: C2.1, U2.10 (VSS); also elsewhere on the board
unnamed: K1.3, U1.16 (O1)
unnamed: K2.3, U1.15 (O2)
unnamed: K3.3, U1.14 (O3)
unnamed: K4.3, U1.13 (O4)
unnamed: K5.3, U1.12 (O5)
unnamed: K6.3, U1.11 (O6)
unnamed: K7.3, U1.10 (O7)
unnamed: K8.3, U3.16 (O1)
unnamed: K9.3, U3.15 (O2)
unnamed: K10.3, U3.14 (O3)
unnamed: K11.3, U3.13 (O4)
unnamed: K12.3, U3.12 (O5)
unnamed: K13.3, U3.11 (O6)
unnamed: K14.3, U3.10 (O7)
VD: K4.1, K5.1, K11.7, K12.7, K13.7; also elsewhere on the board
VS: K6.1, K8.7, K9.7, K10.7, K14.1; also elsewhere on the board

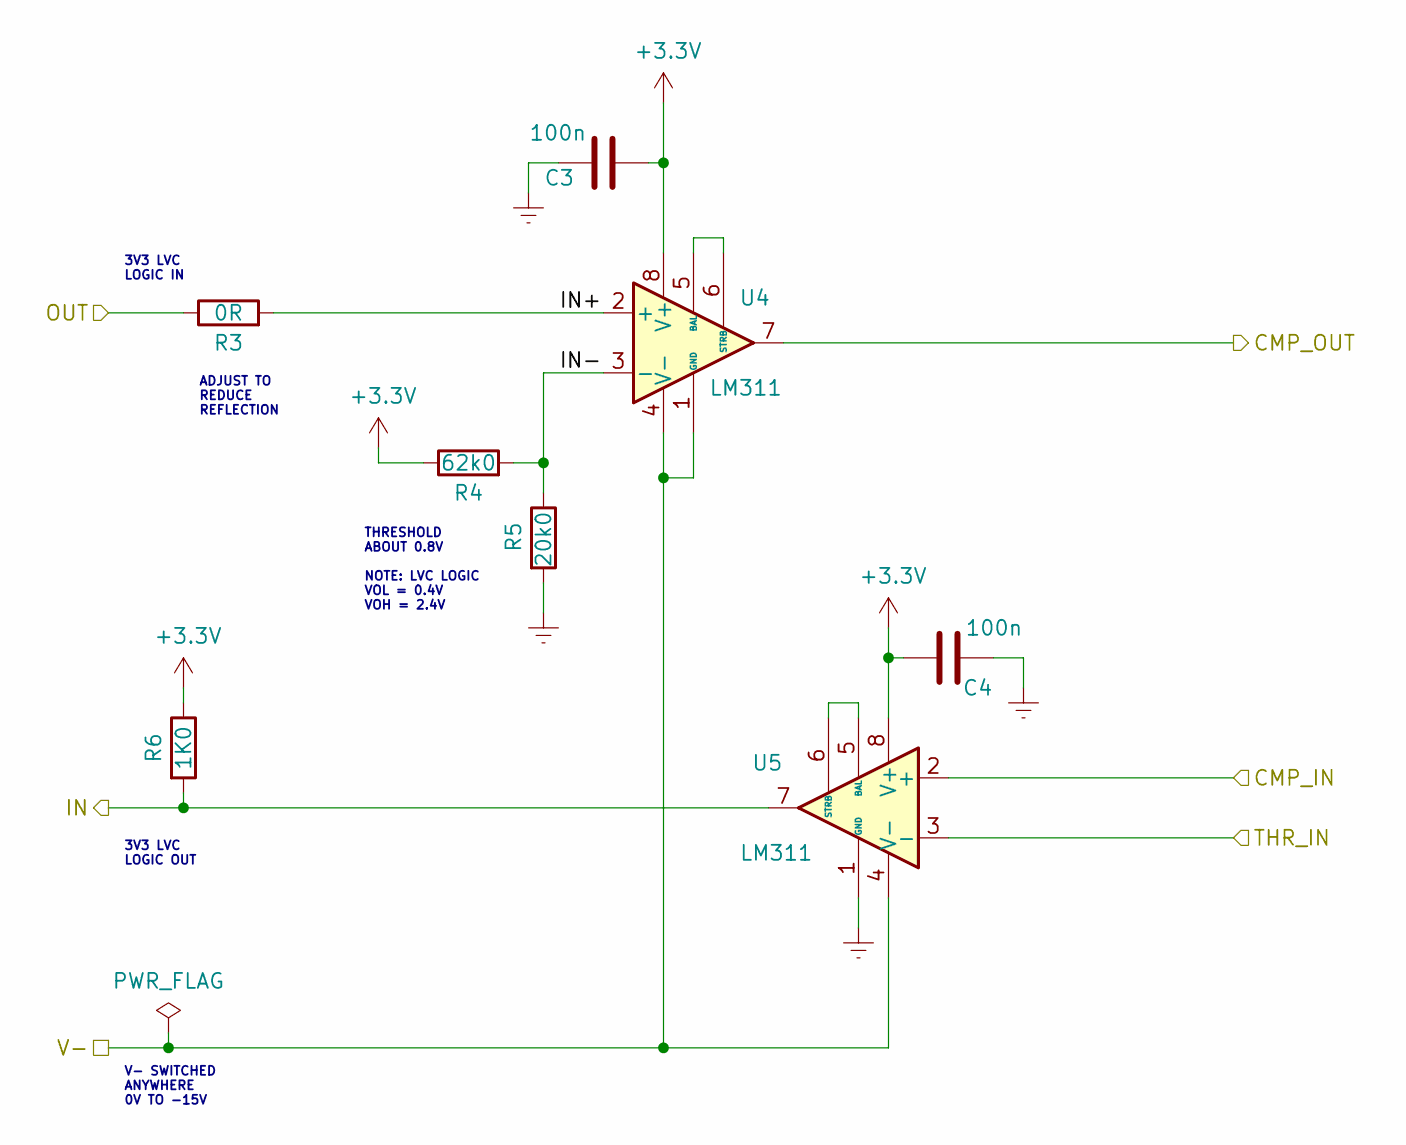
[picture p14: schematic interface.sch, PIN COMPARATORS]

Parts:
C3, C4: 100n; C_0603_1608Metric
R3: 0R; R_0603_1608Metric
R4: 62k0; R_0603_1608Metric
R5: 20k0; R_0603_1608Metric
R6: 1K0; R_0603_1608Metric
U4, U5: LM311; SO-8_3.9x4.9mm_P1.27mm

Connections:
+3V3: C3.1, C4.1, R4.1, R6.1, U4.8 (V+), U5.8 (V+); also elsewhere on the board
/IN: R6.2, U5.7; also elsewhere on the board
/Interface/IN+: R3.2, U4.2 (+)
/Interface/IN-: R4.2, R5.1, U4.3 (-)
/OUT: R3.1; also elsewhere on the board
/PIN: U5.2 (+); also elsewhere on the board
/SIG_OUT: U4.7; also elsewhere on the board
/VT: U5.3 (-); also elsewhere on the board
GNDREF: C3.2, C4.2, R5.2, U5.1 (GND); also elsewhere on the board
unnamed: U4.5 (BAL), U4.6 (STRB)
unnamed: U5.5 (BAL), U5.6 (STRB)
VS: U4.1 (GND), U4.4 (V-), U5.4 (V-); also elsewhere on the board

Notes on the sheet:
THRESHOLD ABOUT 0.8V NOTE: LVC LOGIC VOL = 0.4V VOH = 2.4V
ADJUST TO REDUCE REFLECTION
3V3 LVC LOGIC IN
V- SWITCHED ANYWHERE 0V TO -15V
3V3 LVC LOGIC OUT

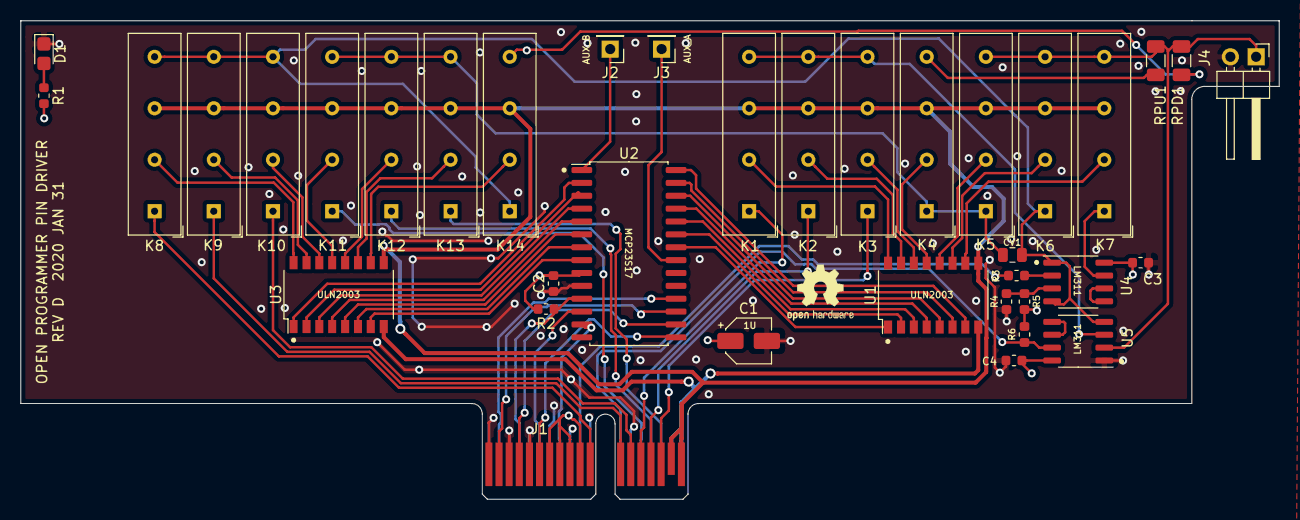
[picture p15: board pin_driver4/pin_driver.kicad_pcb from above]

Board: 4 copper layers, 124.2 x 47.2 mm, 37 parts (0 on the bottom side), 64 nets.
